dbuchwald/Z80DevBoard/README.md

# Z80DevBoard
Simple Z80 based prototyping and development board designed as extension to Arduino Mega 2560
