dbuchwald/Z80DevBoard/Schematic/Z80_Dev_Board/Z80_Dev_Board.kicad_pcb

## KiCad design Schematic/Z80_Dev_Board/Z80_Dev_Board.kicad_pcb (2021-05-11)

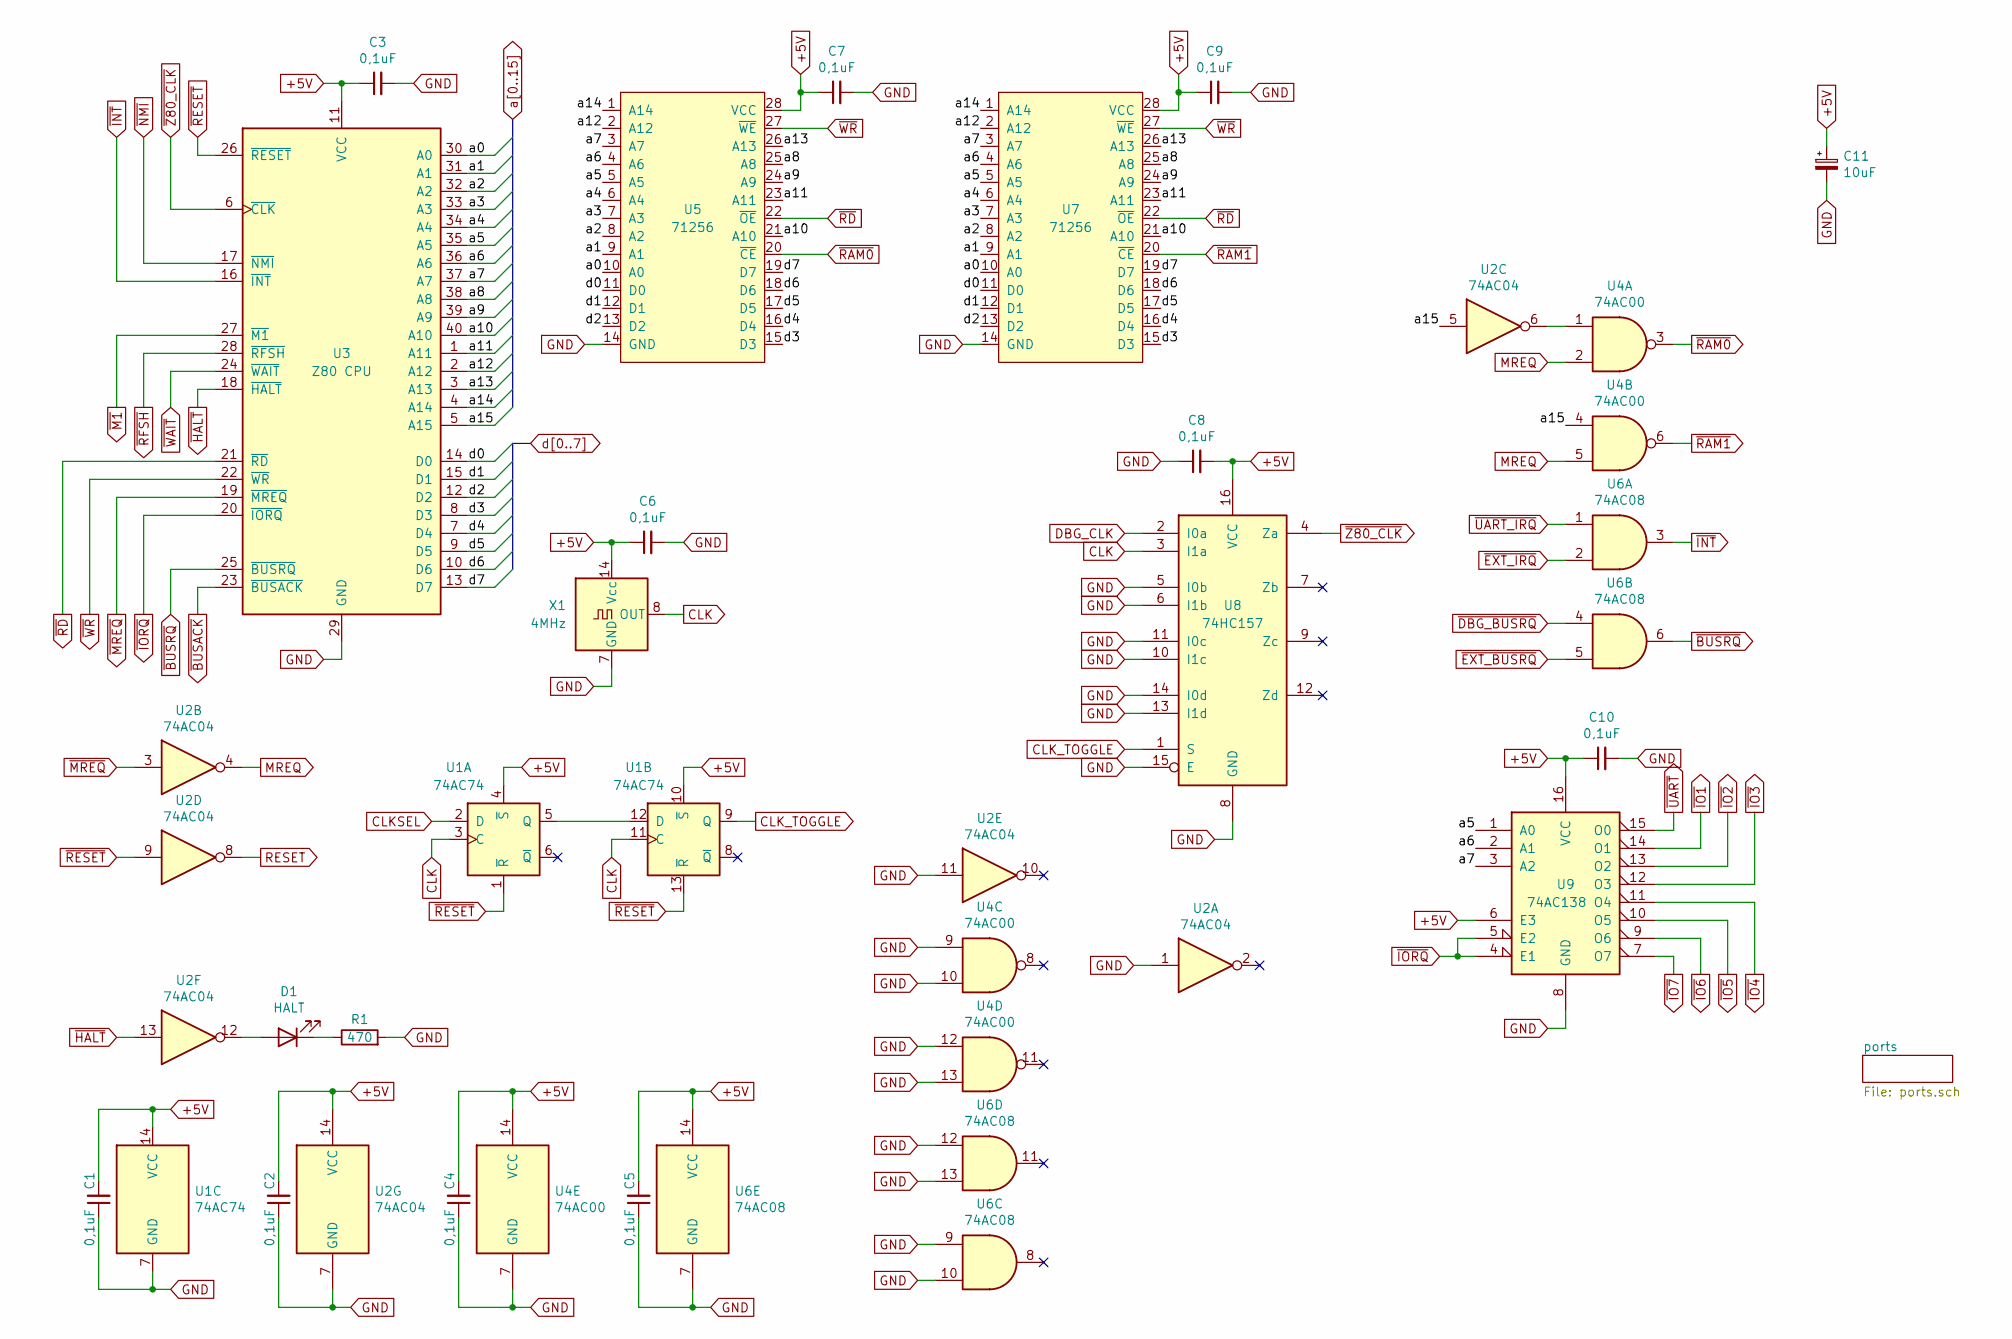
[picture p1: schematic Z80_Dev_Board.sch, Z80 Development Board]

Parts:
C1, C2, C3, C4, C5, C6, C7, C8, C9, C10: 0,1uF; C_1206_3216Metric_Pad1.42x1.75mm_HandSolder
C11: 10uF; CP_Radial_D4.0mm_P1.50mm
D1: HALT; LED_D3.0mm_Clear
R1: 470; R_1206_3216Metric_Pad1.30x1.75mm_HandSolder
U1: 74AC74; SOIC-14_3.9x8.7mm_P1.27mm
U2: 74AC04; SOIC-14_3.9x8.7mm_P1.27mm
U3: Z80 CPU; DIP-40_W15.24mm_Socket
U4: 74AC00; SOIC-14_3.9x8.7mm_P1.27mm
U5, U7: 71256; DIP-28_W7.62mm_Socket
U6: 74AC08; SOIC-14_3.9x8.7mm_P1.27mm
U8: 74HC157; SOIC-16_3.9x9.9mm_P1.27mm
U9: 74AC138; SOIC-16_3.9x9.9mm_P1.27mm
X1: 4MHz; Oscillator_DIP-14

Connections:
+5V: C1.2, C2.2, C3.1, C4.2, C5.2, C6.1, C7.1, C8.2, C9.1, C10.1, C11.1, U1.4 (~S), U1.10 (~S), U1.14 (VCC), U2.14 (VCC), U3.11 (VCC), U4.14 (VCC), U5.28 (VCC), U6.14 (VCC), U7.28 (VCC), U8.16 (VCC), U9.6 (E3), U9.16 (VCC), X1.14 (Vcc); also elsewhere on the board
CLK: U1.3 (C), U1.11 (C), U8.3 (I1a), X1.8 (OUT)
CLKSEL: U1.2 (D); also elsewhere on the board
CLK_TOGGLE: U1.9 (Q), U8.1 (S)
DBG_CLK: U8.2 (I0a); also elsewhere on the board
GND: C1.1, C2.1, C3.2, C4.1, C5.1, C6.2, C7.2, C8.1, C9.2, C10.2, C11.2, R1.2, U1.7 (GND), U2.1, U2.7 (GND), U2.11, U3.29 (GND), U4.7 (GND), U4.9, U4.10, U4.12, U4.13, U5.14 (GND), U6.7 (GND), U6.9, U6.10, U6.12, U6.13, U7.14 (GND), U8.5 (I0b), U8.6 (I1b), U8.8 (GND), U8.10 (I1c), U8.11 (I0c), U8.13 (I1d), U8.14 (I0d), U8.15 (E), U9.8 (GND), X1.7 (GND); also elsewhere on the board
MREQ: U2.4, U4.2, U4.5
unnamed: D1.1 (K), R1.1
unnamed: D1.2 (A), U2.12
unnamed: U1.5 (Q), U1.12 (D)
unnamed: U2.6, U4.1
RESET: U2.8; also elsewhere on the board
a0: U3.30 (A0), U5.10 (A0), U7.10 (A0); also elsewhere on the board
a1: U3.31 (A1), U5.9 (A1), U7.9 (A1); also elsewhere on the board
a2: U3.32 (A2), U5.8 (A2), U7.8 (A2); also elsewhere on the board
a3: U3.33 (A3), U5.7 (A3), U7.7 (A3); also elsewhere on the board
a4: U3.34 (A4), U5.6 (A4), U7.6 (A4); also elsewhere on the board
a5: U3.35 (A5), U5.5 (A5), U7.5 (A5), U9.1 (A0); also elsewhere on the board
a6: U3.36 (A6), U5.4 (A6), U7.4 (A6), U9.2 (A1); also elsewhere on the board
a7: U3.37 (A7), U5.3 (A7), U7.3 (A7), U9.3 (A2); also elsewhere on the board
a8: U3.38 (A8), U5.25 (A8), U7.25 (A8); also elsewhere on the board
a9: U3.39 (A9), U5.24 (A9), U7.24 (A9); also elsewhere on the board
a10: U3.40 (A10), U5.21 (A10), U7.21 (A10); also elsewhere on the board
a11: U3.1 (A11), U5.23 (A11), U7.23 (A11); also elsewhere on the board
a12: U3.2 (A12), U5.2 (A12), U7.2 (A12); also elsewhere on the board
a13: U3.3 (A13), U5.26 (A13), U7.26 (A13); also elsewhere on the board
a14: U3.4 (A14), U5.1 (A14), U7.1 (A14); also elsewhere on the board
a15: U2.5, U3.5 (A15), U4.4; also elsewhere on the board
d0: U3.14 (D0), U5.11 (D0), U7.11 (D0); also elsewhere on the board
d1: U3.15 (D1), U5.12 (D1), U7.12 (D1); also elsewhere on the board
d2: U3.12 (D2), U5.13 (D2), U7.13 (D2); also elsewhere on the board
d3: U3.8 (D3), U5.15 (D3), U7.15 (D3); also elsewhere on the board
d4: U3.7 (D4), U5.16 (D4), U7.16 (D4); also elsewhere on the board
d5: U3.9 (D5), U5.17 (D5), U7.17 (D5); also elsewhere on the board
d6: U3.10 (D6), U5.18 (D6), U7.18 (D6); also elsewhere on the board
d7: U3.13 (D7), U5.19 (D7), U7.19 (D7); also elsewhere on the board
~BUSACK: U3.23 (~BUSACK~); also elsewhere on the board
~BUSRQ: U3.25 (~BUSRQ~), U6.6
~DBG_BUSRQ: U6.4; also elsewhere on the board
~EXT_BUSRQ: U6.5; also elsewhere on the board
~EXT_IRQ: U6.2; also elsewhere on the board
~HALT: U2.13, U3.18 (~HALT~); also elsewhere on the board
~INT: U3.16 (~INT~), U6.3
~IO1: U9.14 (O1); also elsewhere on the board
~IO2: U9.13 (O2); also elsewhere on the board
~IO3: U9.12 (O3); also elsewhere on the board
~IO4: U9.11 (O4); also elsewhere on the board
~IO5: U9.10 (O5); also elsewhere on the board
~IO6: U9.9 (O6); also elsewhere on the board
~IO7: U9.7 (O7); also elsewhere on the board
~IORQ: U3.20 (~IORQ~), U9.4 (E1), U9.5 (E2); also elsewhere on the board
~M1: U3.27 (~M1~); also elsewhere on the board
~MREQ: U2.3, U3.19 (~MREQ~); also elsewhere on the board
~NMI: U3.17 (~NMI~); also elsewhere on the board
~RAM0: U4.3, U5.20 (~CE)
~RAM1: U4.6, U7.20 (~CE)
~RD: U3.21 (~RD~), U5.22 (~OE), U7.22 (~OE); also elsewhere on the board
~RESET: U1.1 (~R), U1.13 (~R), U2.9, U3.26 (~RESET~); also elsewhere on the board
~RFSH: U3.28 (~RFSH~); also elsewhere on the board
~UART: U9.15 (O0); also elsewhere on the board
~UART_IRQ: U6.1; also elsewhere on the board
~WAIT: U3.24 (~WAIT~); also elsewhere on the board
~WR: U3.22 (~WR~), U5.27 (~WE), U7.27 (~WE); also elsewhere on the board
~Z80_CLK: U3.6 (~CLK~), U8.4 (Za); also elsewhere on the board

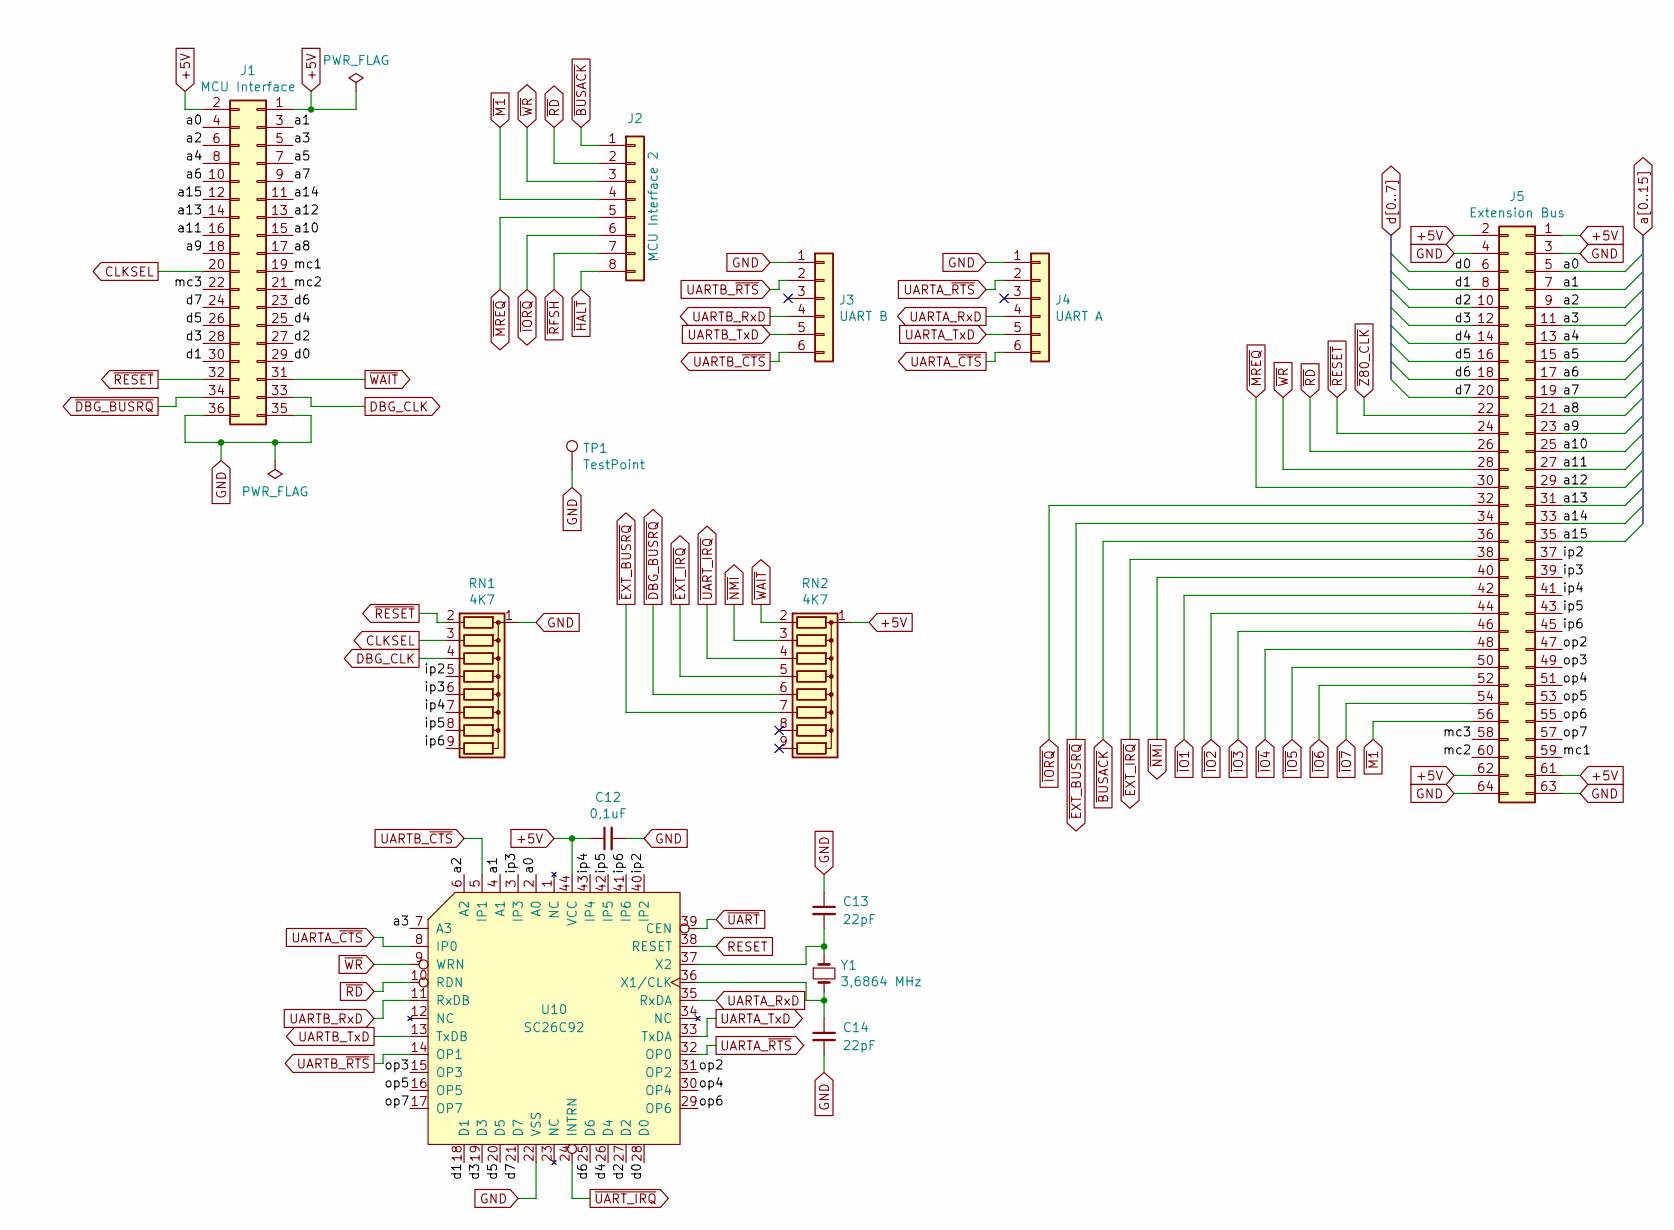
[picture p2: schematic ports.sch, Z80 Development Board]

Parts:
C12: 0,1uF; C_1206_3216Metric_Pad1.42x1.75mm_HandSolder
C13, C14: 22pF; C_1206_3216Metric_Pad1.33x1.80mm_HandSolder
J1: MCU Interface; PinHeader_2x18_P2.54mm_Vertical
J2: MCU Interface 2; PinSocket_1x08_P2.54mm_Vertical
J3: UART B; PinHeader_1x06_P2.54mm_Horizontal
J4: UART A; PinHeader_1x06_P2.54mm_Horizontal
J5: Extension Bus; PinSocket_2x32_P2.54mm_Vertical
RN1, RN2: 4K7; R_Array_SIP9
TP1: TestPoint; TestPoint_Keystone_5005-5009_Compact
U10: SC26C92; PLCC-44_THT-Socket
Y1: 3,6864 MHz; Crystal_HC49-U_Vertical

Connections:
+5V: C12.1, J1.1, J1.2, J5.1, J5.2, J5.61, J5.62, RN2.1 (common), U10.44 (VCC); also elsewhere on the board
/ports/ip2: J5.37, RN1.5 (R4), U10.40 (IP2)
/ports/ip3: J5.39, RN1.6 (R5), U10.3 (IP3)
/ports/ip4: J5.41, RN1.7 (R6), U10.43 (IP4)
/ports/ip5: J5.43, RN1.8 (R7), U10.42 (IP5)
/ports/ip6: J5.45, RN1.9 (R8), U10.41 (IP6)
/ports/mc1: J1.19, J5.59
/ports/mc2: J1.21, J5.60
/ports/mc3: J1.22, J5.58
/ports/op2: J5.47, U10.31 (OP2)
/ports/op3: J5.49, U10.15 (OP3)
/ports/op4: J5.51, U10.30 (OP4)
/ports/op5: J5.53, U10.16 (OP5)
/ports/op6: J5.55, U10.29 (OP6)
/ports/op7: J5.57, U10.17 (OP7)
CLKSEL: J1.20, RN1.3 (R2); also elsewhere on the board
DBG_CLK: J1.33, RN1.4 (R3); also elsewhere on the board
GND: C12.2, C13.1, C14.2, J1.35, J1.36, J3.1, J4.1, J5.3, J5.4, J5.63, J5.64, RN1.1 (common), TP1.1, U10.22 (VSS); also elsewhere on the board
unnamed: C13.2, U10.37 (X2), Y1.1
unnamed: C14.1, U10.36 (X1/CLK), Y1.2
RESET: U10.38 (RESET); also elsewhere on the board
UARTA_RxD: J4.4, U10.35 (RxDA)
UARTA_TxD: J4.5, U10.33 (TxDA)
UARTA_~CTS: J4.6, U10.8 (IP0)
UARTA_~RTS: J4.2, U10.32 (OP0)
UARTB_RxD: J3.4, U10.11 (RxDB)
UARTB_TxD: J3.5, U10.13 (TxDB)
UARTB_~CTS: J3.6, U10.5 (IP1)
UARTB_~RTS: J3.2, U10.14 (OP1)
a0: J1.4, J5.5, U10.2 (A0); also elsewhere on the board
a1: J1.3, J5.7, U10.4 (A1); also elsewhere on the board
a2: J1.6, J5.9, U10.6 (A2); also elsewhere on the board
a3: J1.5, J5.11, U10.7 (A3); also elsewhere on the board
a4: J1.8, J5.13; also elsewhere on the board
a5: J1.7, J5.15; also elsewhere on the board
a6: J1.10, J5.17; also elsewhere on the board
a7: J1.9, J5.19; also elsewhere on the board
a8: J1.17, J5.21; also elsewhere on the board
a9: J1.18, J5.23; also elsewhere on the board
a10: J1.15, J5.25; also elsewhere on the board
a11: J1.16, J5.27; also elsewhere on the board
a12: J1.13, J5.29; also elsewhere on the board
a13: J1.14, J5.31; also elsewhere on the board
a14: J1.11, J5.33; also elsewhere on the board
a15: J1.12, J5.35; also elsewhere on the board
d0: J1.29, J5.6, U10.28 (D0); also elsewhere on the board
d1: J1.30, J5.8, U10.18 (D1); also elsewhere on the board
d2: J1.27, J5.10, U10.27 (D2); also elsewhere on the board
d3: J1.28, J5.12, U10.19 (D3); also elsewhere on the board
d4: J1.25, J5.14, U10.26 (D4); also elsewhere on the board
d5: J1.26, J5.16, U10.20 (D5); also elsewhere on the board
d6: J1.23, J5.18, U10.25 (D6); also elsewhere on the board
d7: J1.24, J5.20, U10.21 (D7); also elsewhere on the board
~BUSACK: J2.1, J5.36; also elsewhere on the board
~DBG_BUSRQ: J1.34, RN2.6 (R5); also elsewhere on the board
~EXT_BUSRQ: J5.34, RN2.7 (R6); also elsewhere on the board
~EXT_IRQ: J5.38, RN2.5 (R4); also elsewhere on the board
~HALT: J2.8; also elsewhere on the board
~IO1: J5.42; also elsewhere on the board
~IO2: J5.44; also elsewhere on the board
~IO3: J5.46; also elsewhere on the board
~IO4: J5.48; also elsewhere on the board
~IO5: J5.50; also elsewhere on the board
~IO6: J5.52; also elsewhere on the board
~IO7: J5.54; also elsewhere on the board
~IORQ: J2.6, J5.32; also elsewhere on the board
~M1: J2.4, J5.56; also elsewhere on the board
~MREQ: J2.5, J5.30; also elsewhere on the board
~NMI: J5.40, RN2.3 (R2); also elsewhere on the board
~RD: J2.2, J5.26, U10.10 (RDN); also elsewhere on the board
~RESET: J1.32, J5.24, RN1.2 (R1); also elsewhere on the board
~RFSH: J2.7; also elsewhere on the board
~UART: U10.39 (CEN); also elsewhere on the board
~UART_IRQ: RN2.4 (R3), U10.24 (INTRN); also elsewhere on the board
~WAIT: J1.31, RN2.2 (R1); also elsewhere on the board
~WR: J2.3, J5.28, U10.9 (WRN); also elsewhere on the board
~Z80_CLK: J5.22; also elsewhere on the board

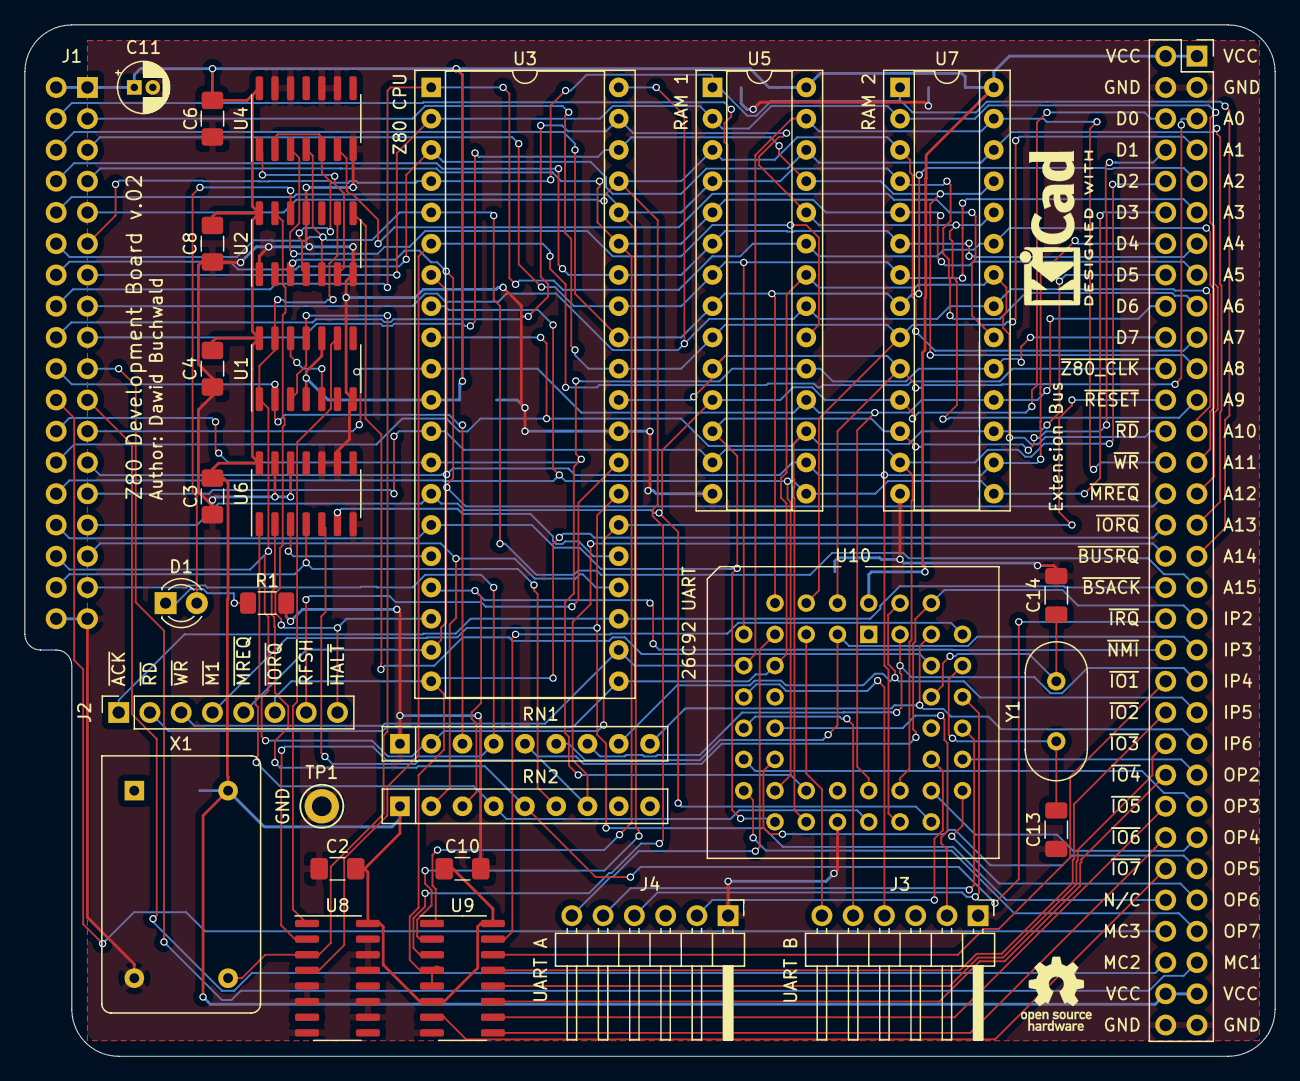
[picture p3: board Z80_Dev_Board.kicad_pcb from above]

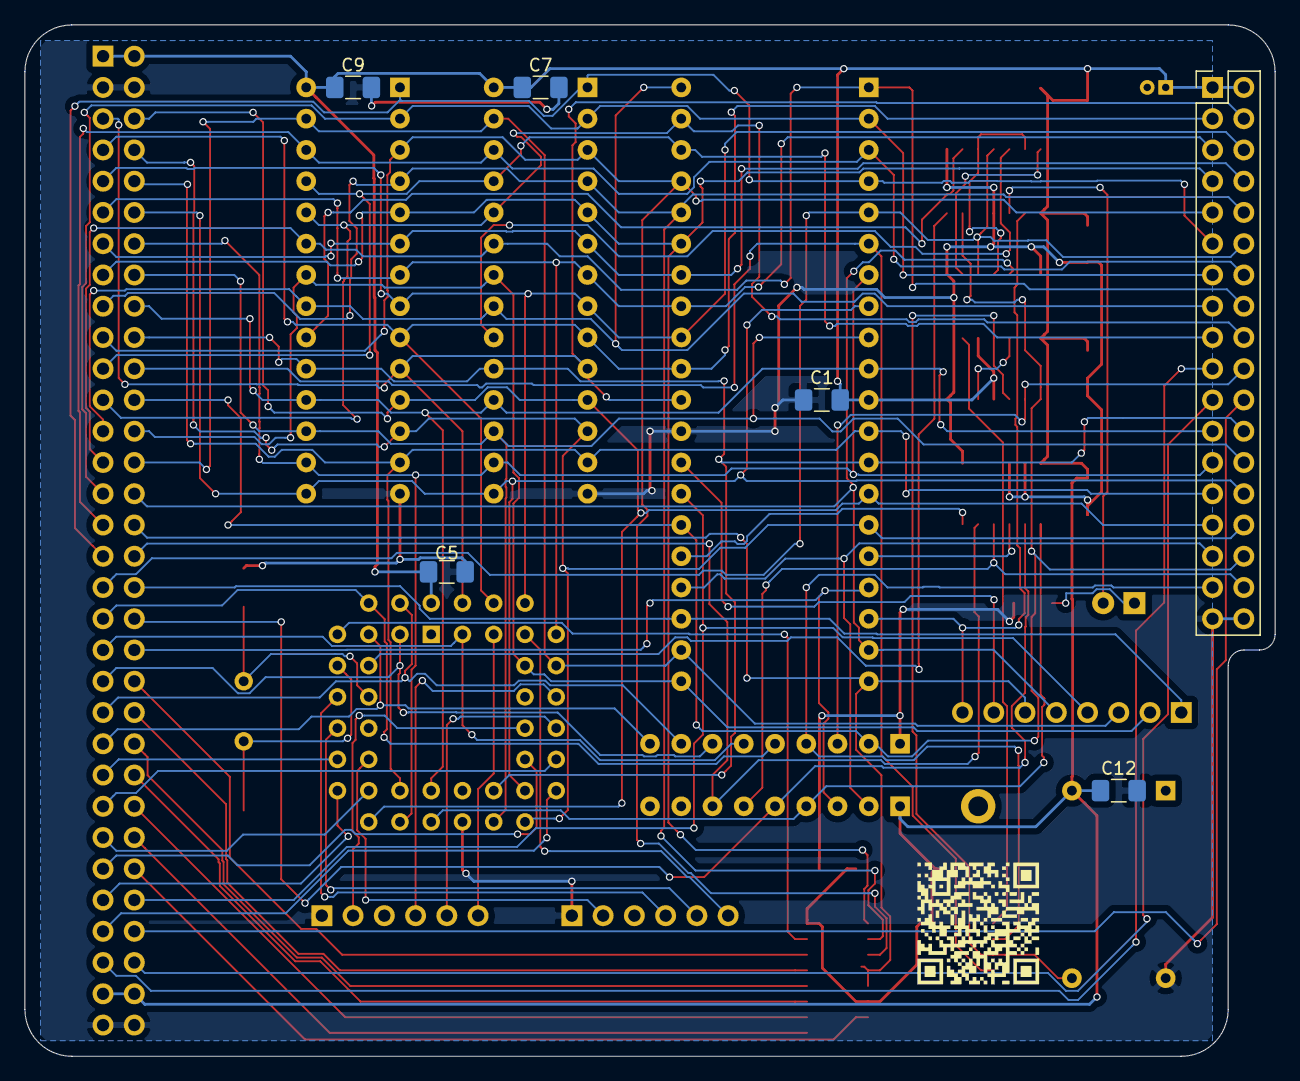
[picture p4: board Z80_Dev_Board.kicad_pcb from below]

Board: 2 copper layers, 101.6 x 83.8 mm, 37 parts (7 on the bottom side), 88 nets.

Other parts of the board:
QR*****: z80_github
