dbuchwald/Z80DevBoard/(commit log)

2020-11-15 Initial schematic commit - CPU, RAM, MCU Interface
    [Z80_Dev_Board.kicad_pcb, Z80_Dev_Board.sch]
2020-11-15 Added basic glue logic and clock toggle circuit
    [Z80_Dev_Board.sch]
2020-11-15 Completed basic schematic
    [Z80_Dev_Board.sch]
2020-11-17 Updated schematic
    [Z80_Dev_Board.sch]
2020-11-17 Added HALT LED, moved things around
    [Z80_Dev_Board.sch, ports.sch]
2020-11-17 Started second PCB attempt
2020-11-17 Added global bus labels
    [Z80_Dev_Board.sch, ports.sch]
2020-11-17 PCB designed
    [Z80_Dev_Board.kicad_pcb]
2020-11-17 PCB RC1
    [Z80_Dev_Board.kicad_pcb, Z80_Dev_Board.sch, ports.sch]
2020-11-19 Small cosmetic updates to PCB
    [Z80_Dev_Board.kicad_pcb]
2020-11-19 Completed PCB rework
    [Z80_Dev_Board.kicad_pcb, ports.sch]
2020-11-19 PCB RC2 with gerbers
    [Z80_Dev_Board-B_Cu.gbl, Z80_Dev_Board-B_Mask.gbs, Z80_Dev_Board-B_Paste.gbp, Z80_Dev_Board-B_SilkS.gbo, Z80_Dev_Board-Edge_Cuts.gm1, Z80_Dev_Board-F_Cu.gtl, Z80_Dev_Board-F_Mask.gts, Z80_Dev_Board-F_Paste.gtp]
2020-11-19 PCB RC3 with gerbers
    [Z80_Dev_Board-B_Cu.gbl, Z80_Dev_Board-B_Mask.gbs, Z80_Dev_Board-B_Paste.gbp, Z80_Dev_Board-B_SilkS.gbo, Z80_Dev_Board-Edge_Cuts.gm1, Z80_Dev_Board-F_Cu.gtl, Z80_Dev_Board-F_Mask.gts, Z80_Dev_Board-F_Paste.gtp]
2020-11-19 Initial adaptation of DB6502 supervisor to Z80 board
2020-11-28 First UART test program
2021-01-30 Started working on updated PCB with IO decoder
    [BOM.xlsx, Z80_Dev_Board.csv, Z80_Dev_Board.kicad_pcb, Z80_Dev_Board.sch]
2021-01-30 Replaced A15 by A07 in UART selection
    [Z80_Dev_Board-B_Cu.gbl, Z80_Dev_Board-B_Mask.gbs, Z80_Dev_Board-B_Paste.gbp, Z80_Dev_Board-B_SilkS.gbo, Z80_Dev_Board-Edge_Cuts.gm1, Z80_Dev_Board-F_Cu.gtl, Z80_Dev_Board-F_Mask.gts, Z80_Dev_Board-F_Paste.gtp]
2021-03-18 New version of the board created
    [Z80_Dev_Board.kicad_pcb, Z80_Dev_Board.sch, ports.sch]
2021-03-20 Started working on IRQ UART program
2021-03-20 Implemented basic UART IRQ based RX-TX loop
2021-03-20 Small update to silkscreen
    [Z80_Dev_Board.kicad_pcb]
2021-04-25 Updated gerbers for second revision of the board
    [Z80_Dev_Board-B_Cu.gbl, Z80_Dev_Board-B_Mask.gbs, Z80_Dev_Board-B_Paste.gbp, Z80_Dev_Board-B_SilkS.gbo, Z80_Dev_Board-Edge_Cuts.gm1, Z80_Dev_Board-F_Cu.gtl, Z80_Dev_Board-F_Mask.gts, Z80_Dev_Board-F_Paste.gtp]
2021-05-08 Replaced THT caps/resistors with SMD
    [Z80_Dev_Board-B_Cu.gbl, Z80_Dev_Board-B_Mask.gbs, Z80_Dev_Board-B_Paste.gbp, Z80_Dev_Board-B_SilkS.gbo, Z80_Dev_Board-Edge_Cuts.gm1, Z80_Dev_Board-F_Cu.gtl, Z80_Dev_Board-F_Mask.gts, Z80_Dev_Board-F_Paste.gtp]
2021-05-08 Removed CSV file
    [Z80_Dev_Board.csv]
2021-05-10 Last-minute updates to board layout (and clock toggle schematic)
    [Z80_Dev_Board-B_Cu.gbl, Z80_Dev_Board-B_Mask.gbs, Z80_Dev_Board-B_SilkS.gbo, Z80_Dev_Board-Edge_Cuts.gm1, Z80_Dev_Board-F_Cu.gtl, Z80_Dev_Board-F_Mask.gts, Z80_Dev_Board-F_SilkS.gto, Z80_Dev_Board.drl]
2021-05-11 Added QR code for github project
    [Z80_Dev_Board-B_Cu.gbl, Z80_Dev_Board-B_Mask.gbs, Z80_Dev_Board-B_SilkS.gbo, Z80_Dev_Board-Edge_Cuts.gm1, Z80_Dev_Board-F_Cu.gtl, Z80_Dev_Board-F_Mask.gts, Z80_Dev_Board-F_SilkS.gto, Z80_Dev_Board.drl]
2021-05-18 Added support for external oscillator and new board
    [core.c, monitor_shell.c, z80db.c]
2021-05-20 Adapted code to board version 2 (proper I/O decoding)
